Claegtun/Handspektrumanalysator/Simulationen/filter_band.asc

C5: cap; 1n
C6: cap; 1n
C7: cap; 100n
C8: cap; 100n
R9: res; 3.09k
R10: res; 32.4k
R11: res; 22.4k
R12: res; 2.49k
R13: res; 68.2k
R14: res; 368k
R15: res; 878k
R16: res; 97.6k
U3: UniversalOpAmp
U4: UniversalOpAmp
V1: voltage; 2.0
V2: voltage; 2.0
V3: voltage; SINE(0 0 1k); AC 1
V4: voltage; 1; Rser=500
Named nets: Vdd, 0, Vss, Vin
.tran 10m
;ac dec 10 1 500k
Ein Bandfilter
