Claegtun/Handspektrumanalysator/Simulationen/preamplifier_zv.asc

C1: cap; 1µ
R1: res; 100
R2: res; 9k
R3: res; 1Meg
U1: opamp2; TL972
V1: voltage; 2.0
V2: voltage; 2.0
V3: voltage; SINE(0 10m 1k); AC 1
V4: voltage; 0
Named nets: Vdd, 0, Vss, Vin, Vout
;tran 10m
;ac dec 10 1 100k
Ein Vorverstärker mit zwei Versorgungen
.lib TL972.lib
.noise V(Vout) V3 dec 10 1 500k
