Claegtun/Handspektrumanalysator/Simulationen/zwei_stufen.asc

C1: cap; 1µ
C2: cap; 3.3n
C3: cap; 7.5n
R1: res; 1k
R2: res; 5k
R3: res; 2.1k
R4: res; 1k
U1: ADA4895
U2: opamp2; TL972
V1: voltage; 2.5
V2: voltage; 2.5
V3: voltage; SINE(0 10m 1k); AC 1
V4: voltage; 1
Named nets: Vdd, 0, Vss, Vin, Vout
.tran 10m
;ac dec 10 1 500k
Zwei Stufen, Ein Vorverstärker und Ein Tiefpassfilter
;noise V(Vout) V3 dec 10 1 500k
.lib TL972.lib
