Claegtun/Handspektrumanalysator/Simulationen/zwei_stufen_einfachversorgung.asc

C1: cap; 10µ
C2: cap; 3.3n
C3: cap; 7.5n
R1: res; 150
R2: res; 13k
R3: res; 2.1k
R4: res; 1k
R5: res; 3.3k
R6: res; 3.3k
R7: res; 150
U2: opamp2; TL972
U3: AD8676
V1: voltage; 5
V2: voltage; 0
V3: voltage; SINE(0 10m 1k); AC 1
V4: voltage; 1; Rser=400
Named nets: Vdd, 0, Vss, Vin, Vout
;tran 10m
.ac dec 10 1 500k
Zwei Stufen, ein Vorverstärker und ein Tiefpassfilter, mit einer Versorgung
;noise V(Vout) V3 dec 10 1 500k
.lib TL972.lib
.lib ada4898.cir
