Claegtun/Handspektrumanalysator/Simulationen/zwei_stufen_zweifachversorgung.asc

C1: cap; 10µ
C2: cap; 3n
C3: cap; 6.8n
C4: cap; 100n
C5: cap; 1µ
C6: cap; 1µ
C7: cap; 100n
C8: cap; 100n
C9: cap; 100n
C10: cap; 100n
C11: cap; 100n
C12: cap; 100n
R1: res; 100
R2: res; 16k
R3: res; 2.1k
R4: res; 1k
R5: res; 7.5k
R6: res; 100k
R7: res; 100k
U1: LT1097
U2: AD8655
U3: AD8655
V1: voltage; 5
V3: voltage; SINE(0 10m 1k); AC 1
V4: voltage; 1; Rser=400
Named nets: Vdd, Vss, COM, Vin, Vout, 0
;tran 10m
.ac dec 10 1 500k
Zwei Stufen, ein Vorverstärker und ein Tiefpassfilter, mit einer geteilter Versorgung
;noise V(Vout) V3 dec 10 1 22.1k
.lib TL972.lib
.lib ada4898.cir
Anderenfalls benutzt man 1uF und 7.5k.
