Claegtun/Handspektrumanalysator/Leiterplatte/hsa_r0.kicad_pcb

## KiCad design Leiterplatte/hsa_r0.kicad_pcb (2025-02-14)

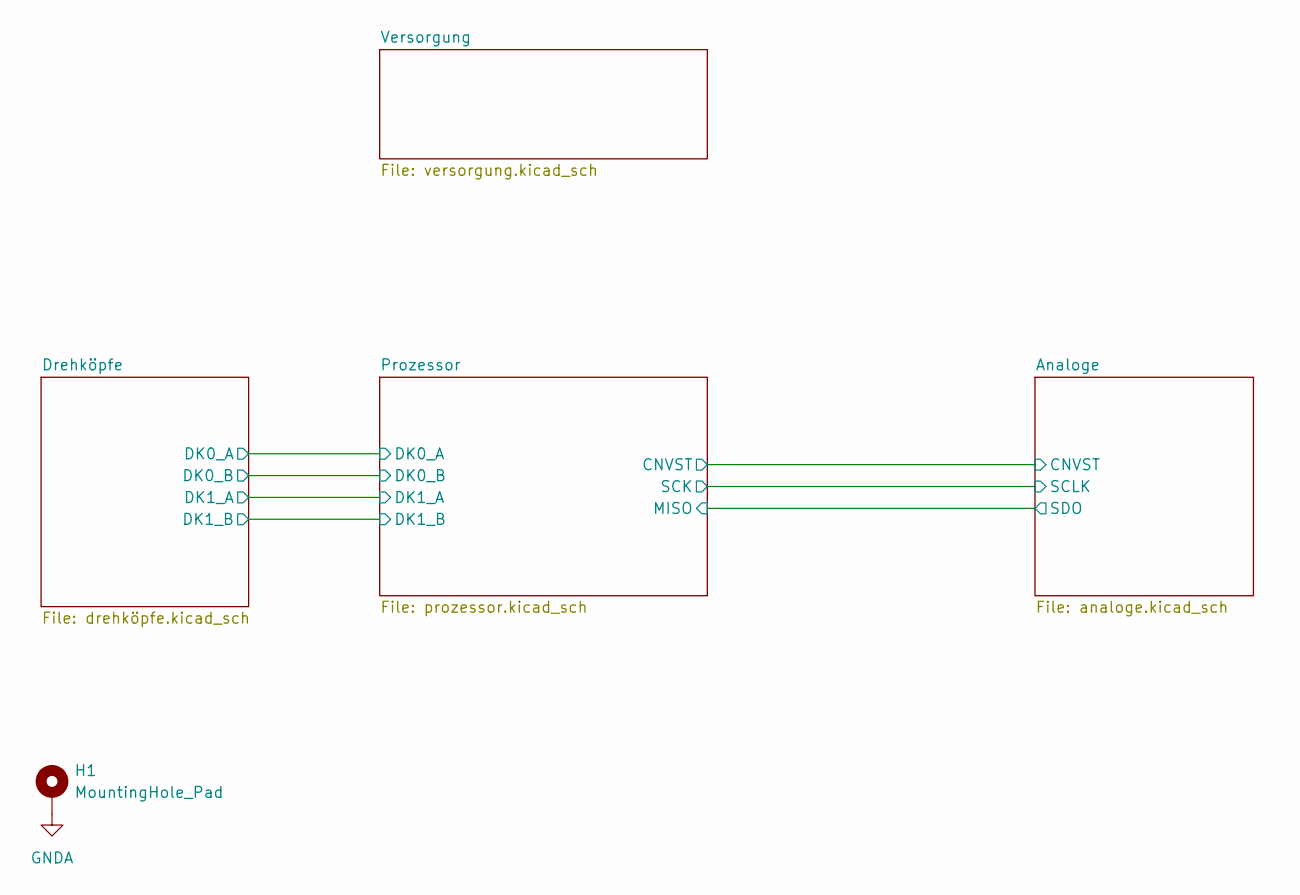
[picture p1: schematic hsa_r0.kicad_sch]

Parts:
H1: MountingHole_Pad; MountingHole_3.2mm_M3_ISO7380_Pad_TopBottom

Connections:
GNDA: H1.1; also elsewhere on the board

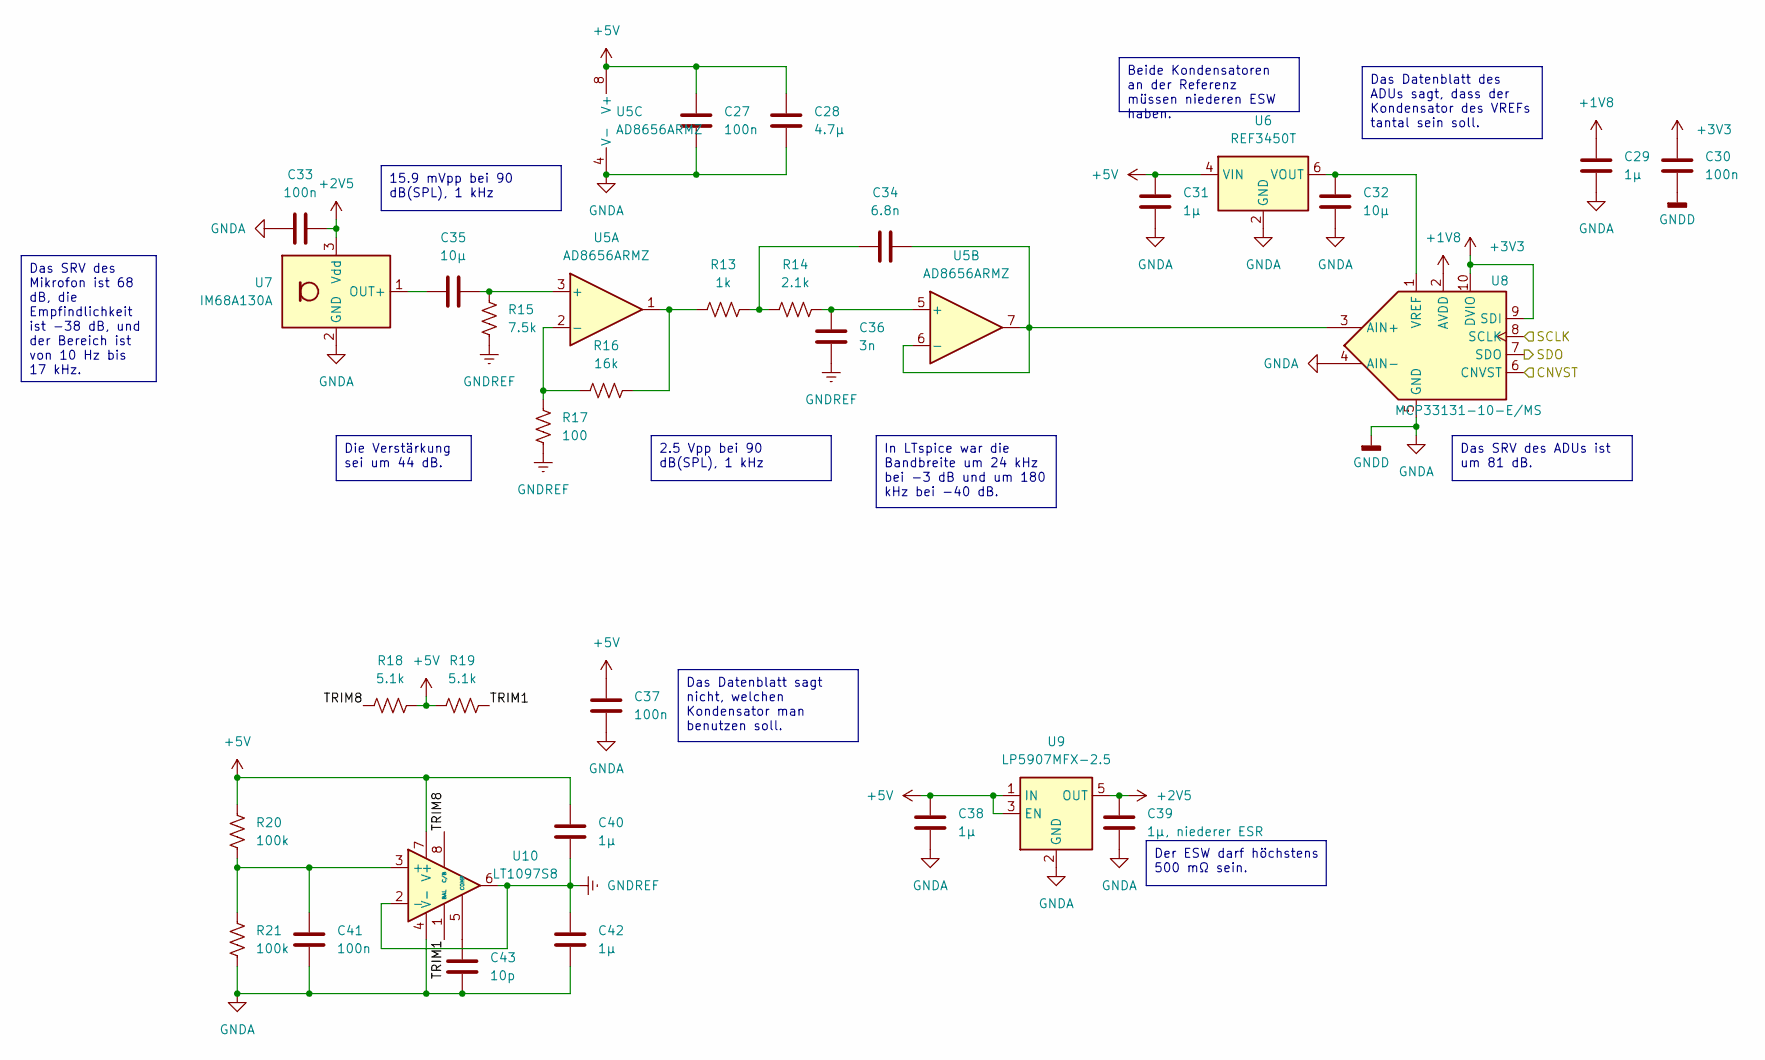
[picture p2: schematic analoge.kicad_sch]

Parts:
C27, C30, C33, C37, C41: 100n; C_0603_1608Metric
C28: 4.7μ; C_1206_3216Metric
C29, C40, C42: 1μ; C_0603_1608Metric
C31, C38: 1μ; C_1206_3216Metric
C32: 10μ; C_1206_3216Metric
C34: 6.8n; C_0603_1608Metric
C35: 10μ; C_0603_1608Metric
C36: 3n; C_0603_1608Metric
C39: 1μ, niederer ESR; C_1206_3216Metric
C43: 10p; C_0603_1608Metric
R13: 1k; R_0603_1608Metric
R14: 2.1k; R_0603_1608Metric
R15: 7.5k; R_0603_1608Metric
R16: 16k; R_0603_1608Metric
R17: 100; R_0603_1608Metric
R18, R19: 5.1k; R_0603_1608Metric
R20, R21: 100k; R_0603_1608Metric
U5: AD8656ARMZ; MSOP-8_3x3mm_P0.65mm
U6: REF3450T; SOT-23-6
U7: IM68A130A; IM68A130A_hand
U8: MCP33131-10-E/MS; MSOP-10_3x3mm_P0.5mm
U9: LP5907MFX-2.5; SOT-23-5
U10: LT1097S8; SOIC-8_3.9x4.9mm_P1.27mm

Connections:
+1V8: C29.1, U8.2 (AVDD); also elsewhere on the board
+2V5: C33.2, C39.1, U7.3 (Vdd), U9.5 (OUT)
+3V3: C30.1, U8.9 (SDI), U8.10 (DVIO); also elsewhere on the board
+5V: C27.1, C28.1, C31.1, C37.1, C38.1, C40.1, R18.2, R19.1, R20.1, U5.8 (V+), U6.4 (VIN), U9.1 (IN), U9.3 (EN), U10.7 (V+); also elsewhere on the board
/Analoge/TRIM1: R19.2, U10.1 (BAL)
/Analoge/TRIM8: R18.1, U10.8 (C/B)
/Prozessor/AADU_CNVST: U8.6 (CNVST); also elsewhere on the board
/Prozessor/AADU_MISO: U8.7 (SDO); also elsewhere on the board
/Prozessor/AADU_SCK: U8.8 (SCLK); also elsewhere on the board
GNDA: C27.2, C28.2, C29.2, C30.2, C31.2, C32.2, C33.1, C37.2, C38.2, C39.2, C41.2, C42.2, C43.2, R21.2, U5.4 (V-), U6.2 (GND), U7.2 (GND), U7.4 (GND), U8.4 (AIN-), U8.5 (GND), U9.2 (GND), U10.4 (V-); also elsewhere on the board
GNDREF: C36.1, C40.2, C42.1, R15.1, R17.1, U10.2 (-), U10.6
unnamed: C34.1, R13.2, R14.1
unnamed: R13.1, R16.2, U5.1
unnamed: C35.2, R15.2, U5.3 (+)
unnamed: R16.1, R17.2, U5.2 (-)
unnamed: C36.2, R14.2, U5.5 (+)
unnamed: C34.2, U5.6 (-), U5.7, U8.3 (AIN+)
unnamed: C32.1, U6.6 (VOUT), U8.1 (VREF)
unnamed: C35.1, U7.1 (OUT+)
unnamed: C41.1, R20.2, R21.1, U10.3 (+)
unnamed: C43.1, U10.5 (COMP)

Notes on the sheet:
Das Datenblatt des ADUs sagt, dass der Kondensator des VREFs tantal sein soll.
15.9 mVpp bei 90 dB(SPL), 1 kHz
Das SRV des Mikrofon ist 68 dB, die Empfindlichkeit ist -38 dB, und der Bereich ist von 10 Hz bis 17 kHz.
Die Verstärkung sei um 44 dB.
In LTspice war die Bandbreite um 24 kHz bei -3 dB und um 180 kHz bei -40 dB.
Das SRV des ADUs ist um 81 dB.
Beide Kondensatoren an der Referenz müssen niederen ESW haben.
2.5 Vpp bei 90 dB(SPL), 1 kHz
Der ESW darf höchstens 500 mΩ sein.
Das Datenblatt sagt nicht, welchen Kondensator man benutzen soll.

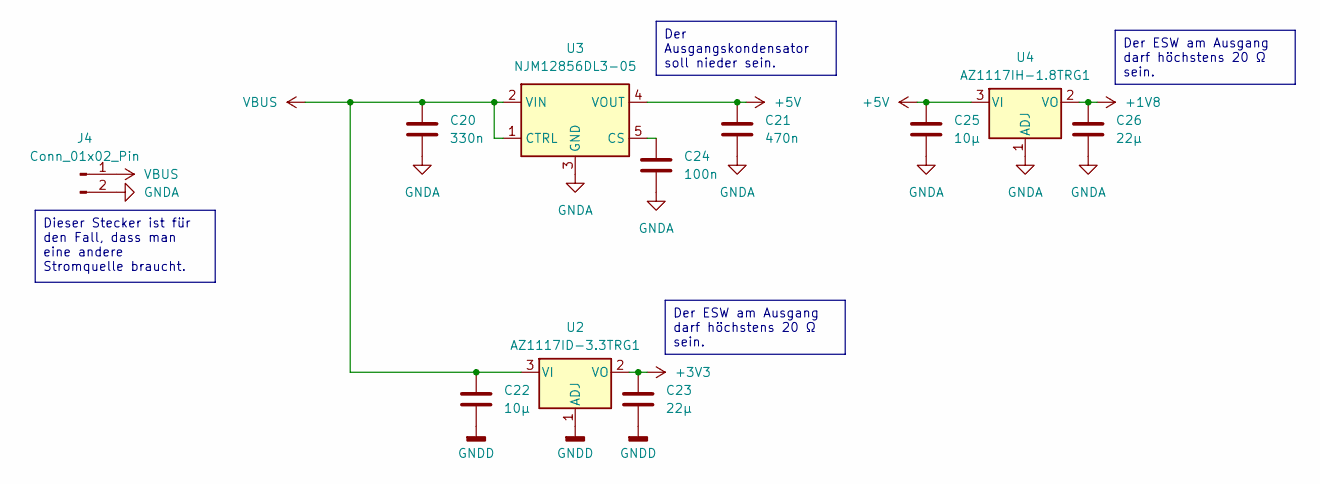
[picture p3: schematic versorgung.kicad_sch]

Parts:
C20: 330n; C_1206_3216Metric
C21: 470n; C_1206_3216Metric
C22, C25: 10μ; C_1206_3216Metric
C23, C26: 22μ; C_1206_3216Metric
C24: 100n; C_0603_1608Metric
J4: Conn_01x02_Pin; PinHeader_1x02_P2.54mm_Vertical
U2: AZ1117ID-3.3TRG1; TO-252-2
U3: NJM12856DL3-05; TO-252-5_TabPin3
U4: AZ1117IH-1.8TRG1; SOT-223-3_TabPin2

Connections:
+1V8: C26.1, U4.2 (VO); also elsewhere on the board
+3V3: C23.1, U2.2 (VO); also elsewhere on the board
+5V: C21.1, C25.1, U3.4 (VOUT), U4.3 (VI); also elsewhere on the board
GNDA: C20.2, C21.2, C22.2, C23.2, C24.2, C25.2, C26.2, J4.2, U2.1 (ADJ), U3.3 (GND), U3.7 (GND), U4.1 (ADJ); also elsewhere on the board
unnamed: C24.1, U3.5 (CS)
VBUS: C20.1, C22.1, J4.1, U2.3 (VI), U3.1 (CTRL), U3.2 (VIN); also elsewhere on the board

Notes on the sheet:
Der Ausgangskondensator soll nieder sein.
Der ESW am Ausgang darf höchstens 20 Ω sein.
Dieser Stecker ist für den Fall, dass man eine andere Stromquelle braucht.

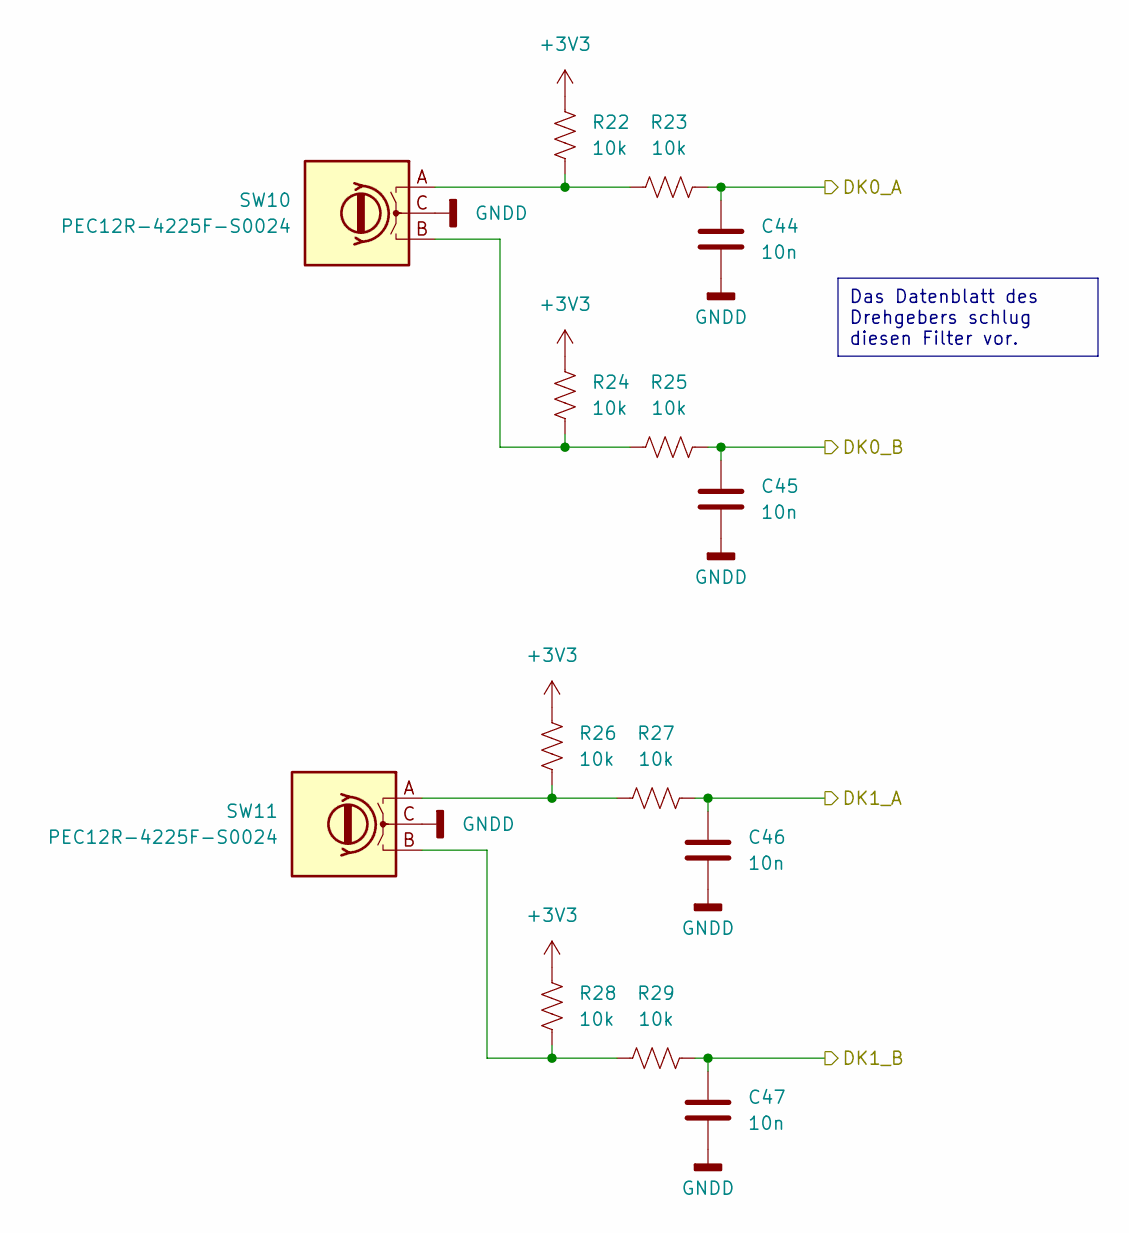
[picture p4: schematic drehköpfe.kicad_sch]

Parts:
C44, C45, C46, C47: 10n; C_0603_1608Metric
R22, R23, R24, R25, R26, R27, R28, R29: 10k; R_0603_1608Metric
SW10, SW11: PEC12R-4225F-S0024; RotaryEncoder_Bourns_Horizontal_PEC09-2xxxF-Nxxxx

Connections:
+3V3: R22.2, R24.2, R26.2, R28.2; also elsewhere on the board
/Prozessor/DK0_A: C44.1, R23.1; also elsewhere on the board
/Prozessor/DK0_B: C45.1, R25.1; also elsewhere on the board
/Prozessor/DK1_A: C46.1, R27.1; also elsewhere on the board
/Prozessor/DK1_B: C47.1, R29.1; also elsewhere on the board
GNDA: C44.2, C45.2, C46.2, C47.2, SW10.C, SW11.C; also elsewhere on the board
unnamed: R22.1, R23.2, SW10.A
unnamed: R24.1, R25.2, SW10.B
unnamed: R26.1, R27.2, SW11.A
unnamed: R28.1, R29.2, SW11.B

Notes on the sheet:
Das Datenblatt des Drehgebers schlug diesen Filter vor.

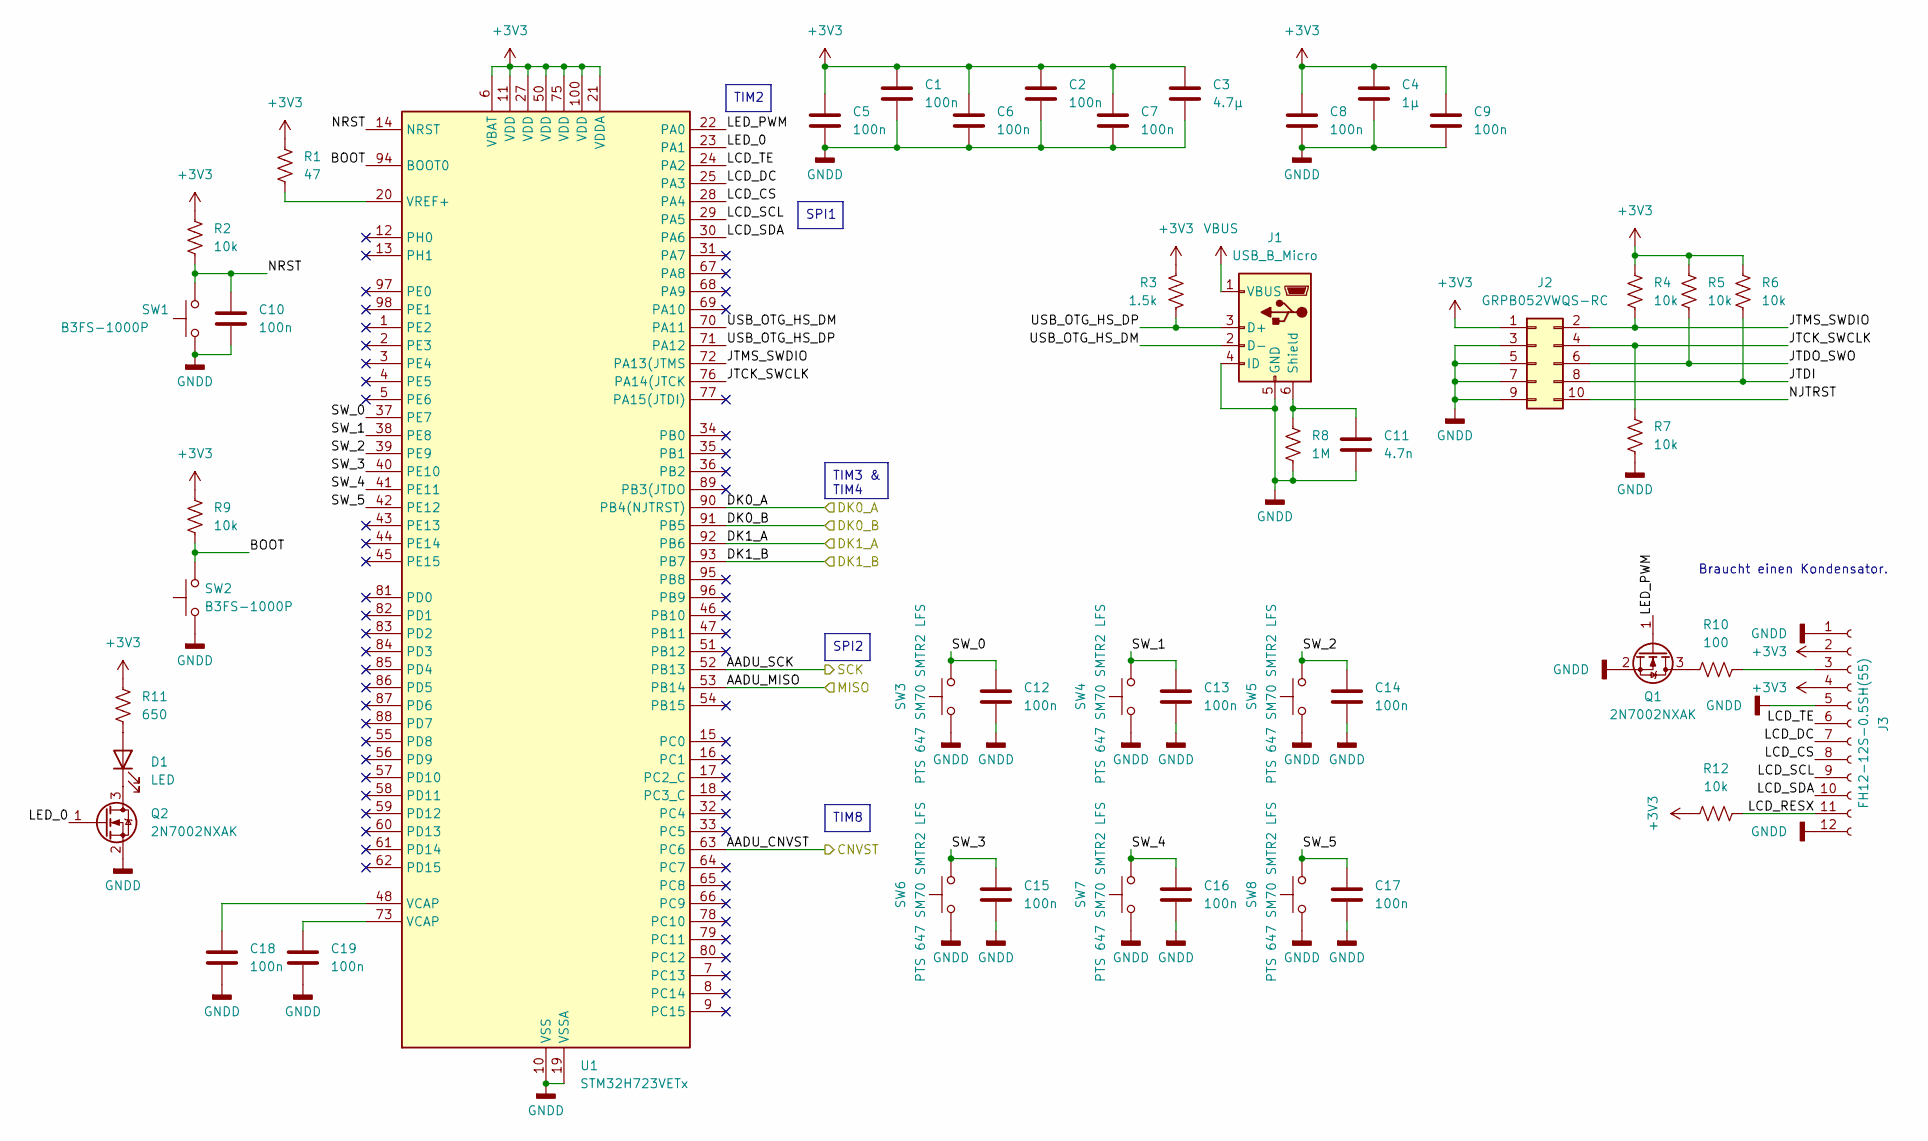
[picture p5: schematic prozessor.kicad_sch]

Parts:
C1, C2, C5, C6, C7, C8, C9, C10, C12, C13, C14, C15, C16, C17, C18, C19: 100n; C_0603_1608Metric
C3: 4.7μ; C_0805_2012Metric
C4: 1μ; C_0805_2012Metric
C11: 4.7n; C_0603_1608Metric
D1: LED; LED_0805_2012Metric
J1: USB_B_Micro; USB_Micro-B_Amphenol_10118193-0001LF_Horizontal
J2: GRPB052VWQS-RC; PinHeader_2x05_P1.27mm_Vertical_SMD
J3: FH12-12S-0.5SH(55); Hirose_FH12-12S-0.5SH_1x12-1MP_P0.50mm_Horizontal
Q1, Q2: 2N7002NXAK; SOT-23
R1: 47; R_0603_1608Metric
R2, R4, R5, R6, R7, R9, R12: 10k; R_0603_1608Metric
R3: 1.5k; R_0603_1608Metric
R8: 1M; R_0603_1608Metric
R10: 100; R_0603_1608Metric
R11: 650; R_0603_1608Metric
SW1, SW2: B3FS-1000P; häufige_kurzhubtaster
SW3, SW4, SW5, SW6, SW7, SW8: PTS 647 SM70 SMTR2 LFS; häufige_kurzhubtaster
U1: STM32H723VETx; LQFP-100_14x14mm_P0.5mm

Connections:
+3V3: C1.1, C2.1, C3.1, C4.1, C5.1, C6.1, C7.1, C8.1, C9.1, J2.1, J3.2, J3.4, R1.2, R2.1, R3.1, R4.1, R5.1, R6.1, R9.1, R11.2, R12.1, U1.6 (VBAT), U1.11 (VDD), U1.21 (VDDA), U1.27 (VDD), U1.50 (VDD), U1.75 (VDD), U1.100 (VDD); also elsewhere on the board
/Prozessor/AADU_CNVST: U1.63 (PC6); also elsewhere on the board
/Prozessor/AADU_MISO: U1.53 (PB14); also elsewhere on the board
/Prozessor/AADU_SCK: U1.52 (PB13); also elsewhere on the board
/Prozessor/BOOT: R9.2, SW2.2, U1.94 (BOOT0)
/Prozessor/DK0_A: U1.90 (PB4(NJTRST)); also elsewhere on the board
/Prozessor/DK0_B: U1.91 (PB5); also elsewhere on the board
/Prozessor/DK1_A: U1.92 (PB6); also elsewhere on the board
/Prozessor/DK1_B: U1.93 (PB7); also elsewhere on the board
/Prozessor/JTCK_SWCLK: J2.4, R7.1, U1.76 (PA14(JTCK)
/Prozessor/JTDI: J2.8, R6.2
/Prozessor/JTDO_SWO: J2.6, R5.2
/Prozessor/JTMS_SWDIO: J2.2, R4.2, U1.72 (PA13(JTMS)
/Prozessor/LCD_CS: J3.8, U1.28 (PA4)
/Prozessor/LCD_DC: J3.7, U1.25 (PA3)
/Prozessor/LCD_RESX: J3.11, R12.2
/Prozessor/LCD_SCL: J3.9, U1.29 (PA5)
/Prozessor/LCD_SDA: J3.10, U1.30 (PA6)
/Prozessor/LCD_TE: J3.6, U1.24 (PA2)
/Prozessor/LED_0: Q2.1 (G), U1.23 (PA1)
/Prozessor/LED_PWM: Q1.1 (G), U1.22 (PA0)
/Prozessor/NJTRST: J2.10
/Prozessor/NRST: C10.1, R2.2, SW1.2, U1.14 (NRST)
/Prozessor/SW_0: C12.1, SW3.1, U1.37 (PE7)
/Prozessor/SW_1: C13.1, SW4.1, U1.38 (PE8)
/Prozessor/SW_2: C14.1, SW5.1, U1.39 (PE9)
/Prozessor/SW_3: C15.1, SW6.1, U1.40 (PE10)
/Prozessor/SW_4: C16.1, SW7.1, U1.41 (PE11)
/Prozessor/SW_5: C17.1, SW8.1, U1.42 (PE12)
/Prozessor/USB_OTG_HS_DM: J1.2 (D-), U1.70 (PA11)
/Prozessor/USB_OTG_HS_DP: J1.3 (D+), R3.2, U1.71 (PA12)
GNDA: C1.2, C2.2, C3.2, C4.2, C5.2, C6.2, C7.2, C8.2, C9.2, C10.2, C11.2, C12.2, C13.2, C14.2, C15.2, C16.2, C17.2, C18.1, C19.2, J1.4 (ID), J1.5 (GND), J2.3, J2.5, J2.7, J2.9, J3.1, J3.5, J3.12, Q1.2 (S), Q2.2 (S), R7.2, R8.2, SW1.1, SW2.1, SW3.2, SW4.2, SW5.2, SW6.2, SW7.2, SW8.2, U1.10 (VSS), U1.19 (VSSA), U1.26 (VSS), U1.49 (VSS), U1.74 (VSS), U1.99 (VSS); also elsewhere on the board
unnamed: C18.2, U1.48 (VCAP)
unnamed: C19.1, U1.73 (VCAP)
unnamed: D1.2 (A), R11.1
unnamed: D1.1 (K), Q2.3 (D)
unnamed: C11.1, J1.6 (Shield), R8.1
unnamed: J3.3, R10.2
unnamed: Q1.3 (D), R10.1
unnamed: R1.1, U1.20 (VREF+)
VBUS: J1.1 (VBUS); also elsewhere on the board

Notes on the sheet:
SPI2
TIM2
TIM3 & TIM4
TIM8
SPI1
Braucht einen Kondensator.

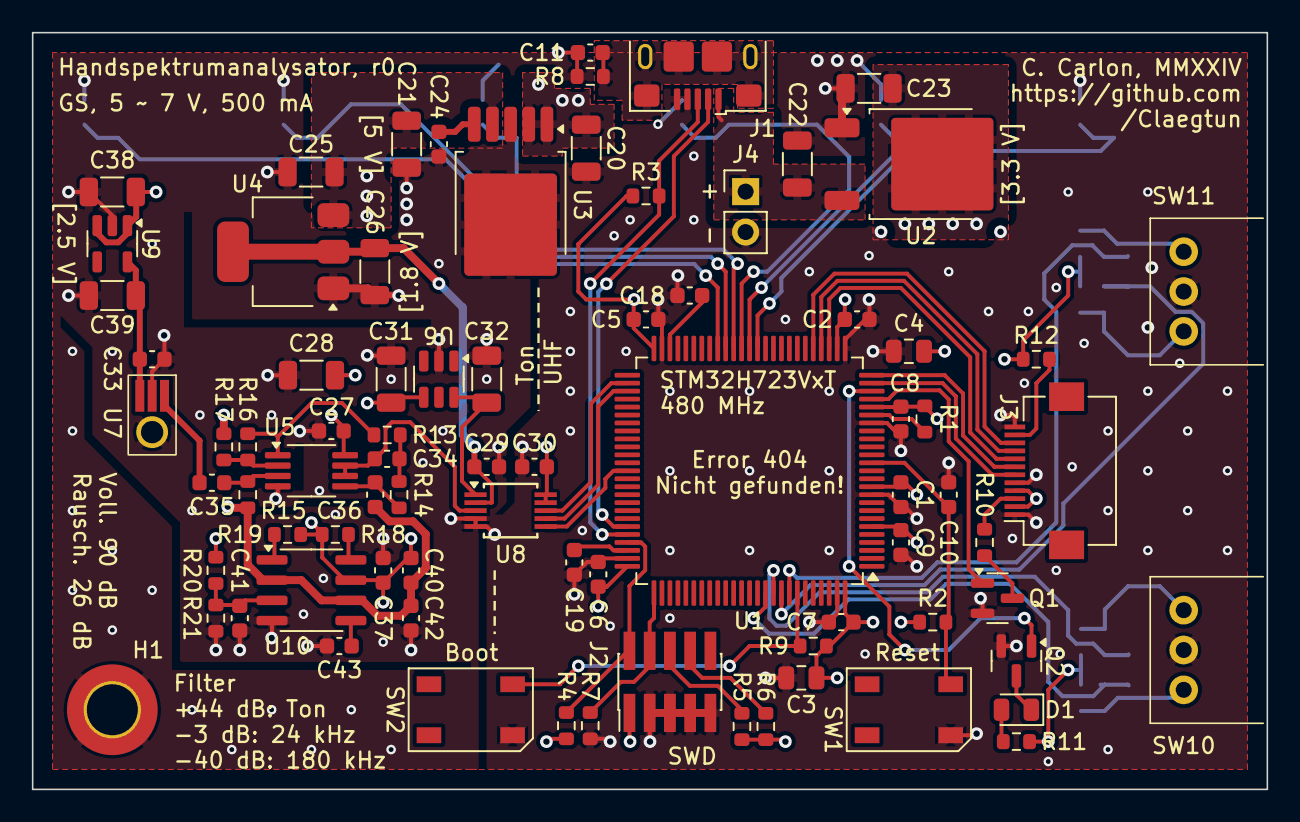
[picture p6: board hsa_r0.kicad_pcb from above]

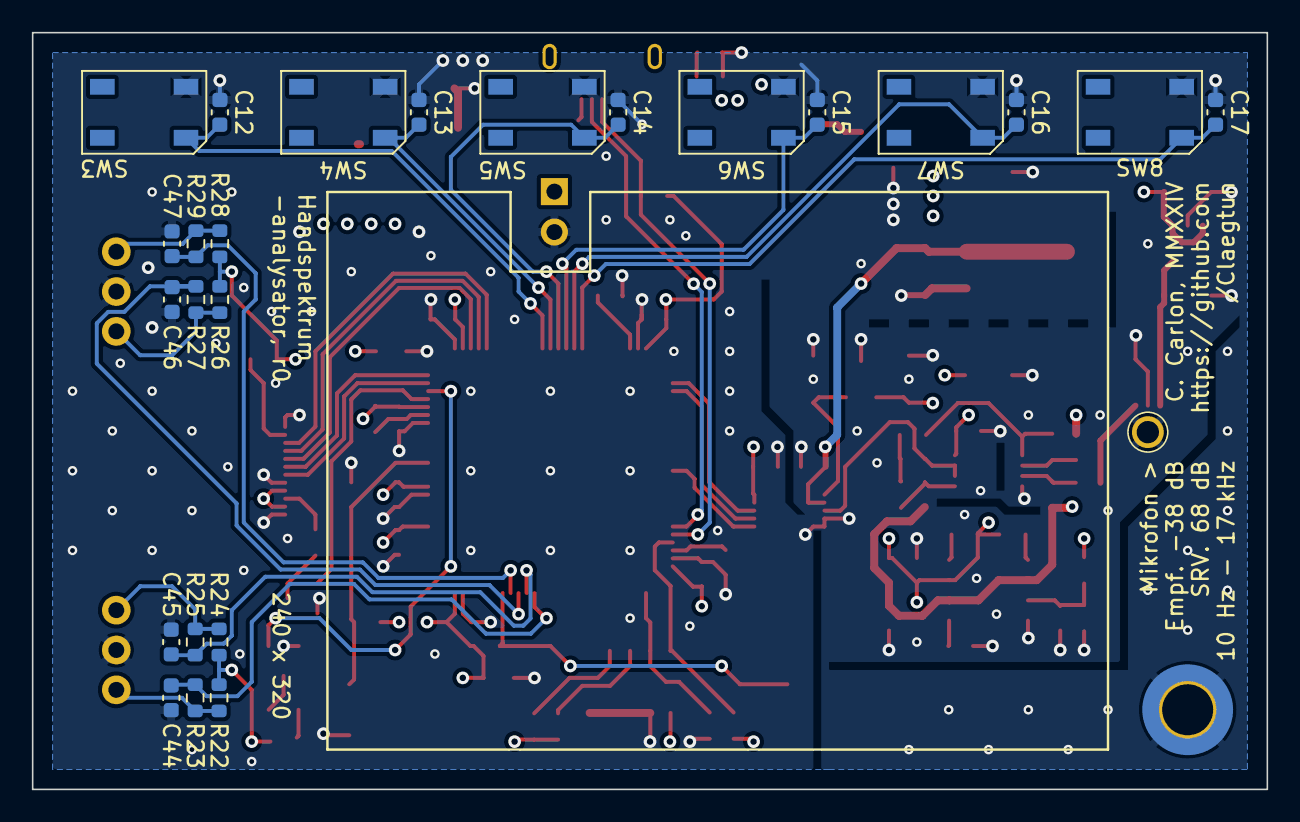
[picture p7: board hsa_r0.kicad_pcb from below]

Board: 4 copper layers, 77.5 x 47.5 mm, 104 parts (24 on the bottom side), 61 nets.
