Claegtun/Handspektrumanalysator/firmware/hsa/src/coefficients.hpp

extern constexpr int16_t coefficients[] = {
    4,12,21,31,43,53,61,64,
    58,39,7,-41,-102,-173,-247,-316,
    -366,-388,-367,-294,-160,37,298,616,
    978,1367,1763,2142,2480,2757,2952,3053,
    3053,2952,2757,2480,2142,1763,1367,978,
    616,298,37,-160,-294,-367,-388,-366,
    -316,-247,-173,-102,-41,7,39,58,
    64,61,53,43,31,21,12,4
};
